klemens13/esp32s2-macropad/hardware/plate_mx_1to1.pdf

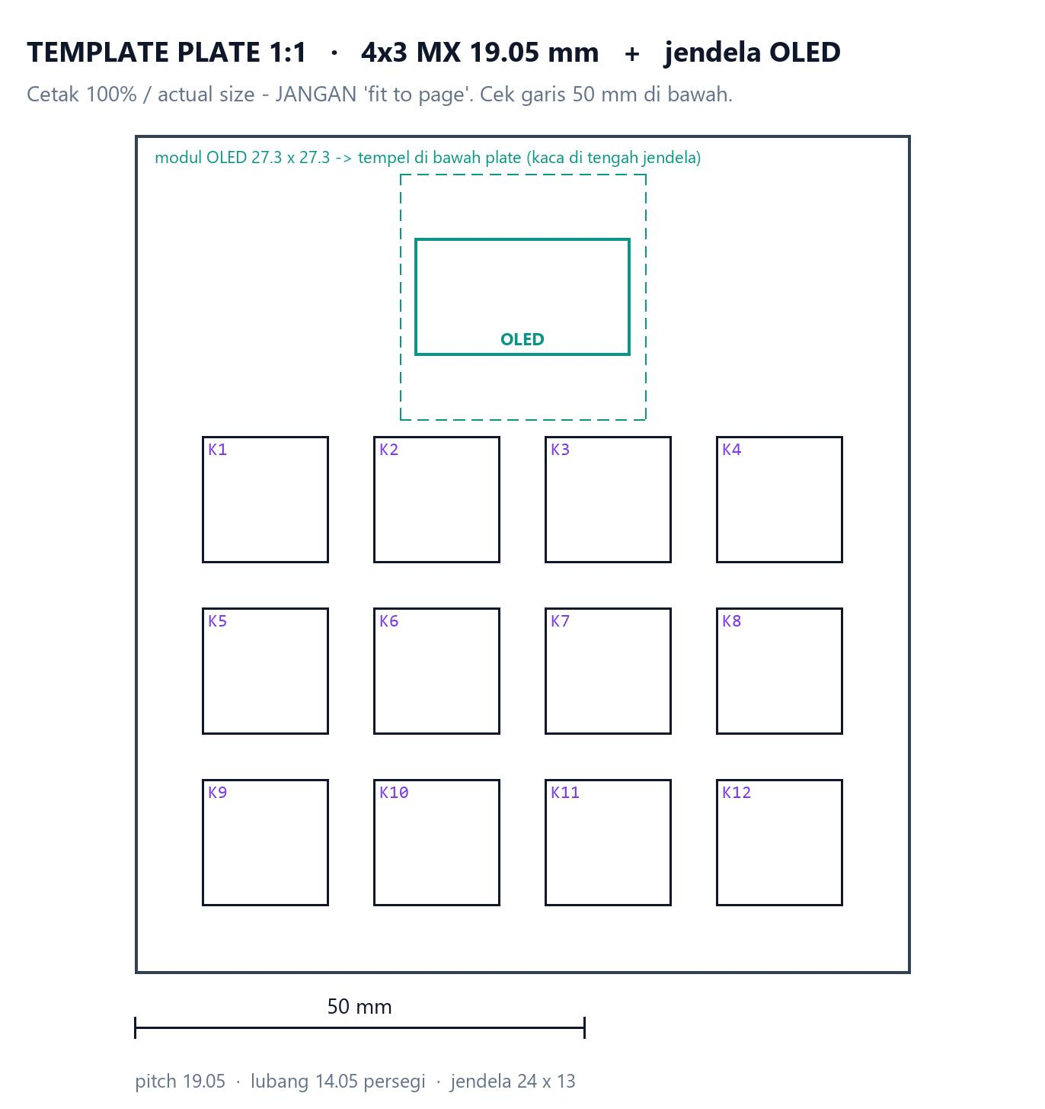
[picture p6: page 1]
