klemens13/esp32s2-macropad/hardware/plate_tactile_1to1.pdf

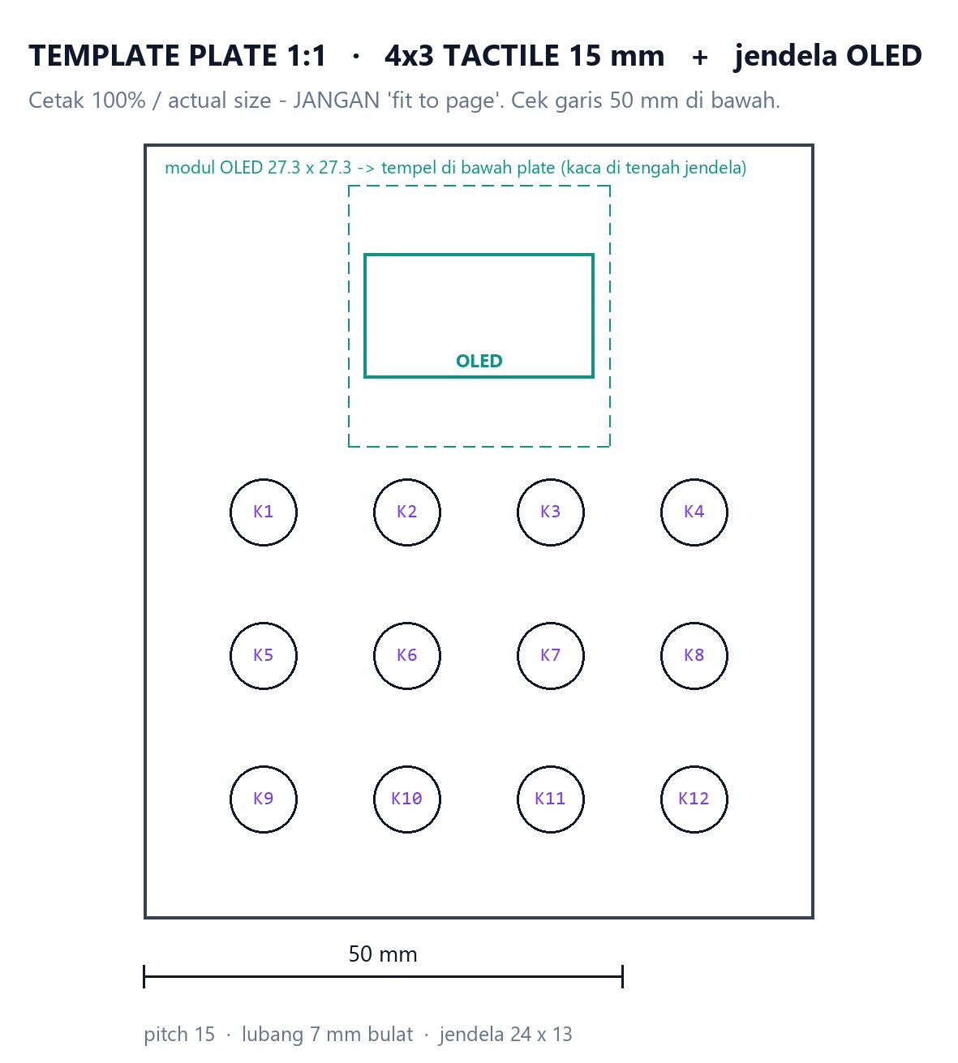
[picture p7: page 1]
