klemens13/esp32s2-macropad/firmware/font5x7.py

"""Font bitmap 5x7 (hanya karakter ini yang tersedia).

Dibuat otomatis oleh tools/gen_font.py - jangan diedit manual.
Setiap glyph = 5 byte, 1 byte per kolom, bit0 = baris paling atas.
"""

GLYPH_WIDTH = 5
GLYPH_HEIGHT = 7
ADVANCE = 6  # lebar glyph + 1 px jarak antar huruf

FONT = {
    0x20: b'\x00\x00\x00\x00\x00',  #  
    0x21: b'\x00\x00\x5f\x00\x00',  # !
    0x22: b'\x00\x03\x00\x03\x00',  # "
    0x25: b'\x63\x13\x08\x64\x63',  # %
    0x27: b'\x00\x00\x03\x00\x00',  # '
    0x28: b'\x00\x1c\x22\x41\x00',  # (
    0x29: b'\x00\x41\x22\x1c\x00',  # )
    0x2A: b'\x2a\x1c\x3e\x1c\x2a',  # *
    0x2B: b'\x08\x08\x3e\x08\x08',  # +
    0x2C: b'\x00\x40\x30\x30\x00',  # ,
    0x2D: b'\x08\x08\x08\x08\x08',  # -
    0x2E: b'\x00\x00\x60\x60\x00',  # .
    0x2F: b'\x60\x10\x08\x04\x03',  # /
    0x30: b'\x3e\x51\x49\x45\x3e',  # 0
    0x31: b'\x00\x42\x7f\x40\x00',  # 1
    0x32: b'\x42\x61\x51\x49\x46',  # 2
    0x33: b'\x21\x41\x45\x4b\x31',  # 3
    0x34: b'\x18\x14\x12\x7f\x10',  # 4
    0x35: b'\x27\x45\x45\x45\x39',  # 5
    0x36: b'\x3c\x4a\x49\x49\x30',  # 6
    0x37: b'\x01\x71\x09\x05\x03',  # 7
    0x38: b'\x36\x49\x49\x49\x36',  # 8
    0x39: b'\x06\x49\x49\x29\x1e',  # 9
    0x3A: b'\x00\x00\x36\x36\x00',  # :
    0x3C: b'\x08\x14\x22\x41\x00',  # <
    0x3D: b'\x14\x14\x14\x14\x14',  # =
    0x3E: b'\x00\x41\x22\x14\x08',  # >
    0x3F: b'\x02\x01\x51\x09\x06',  # ?
    0x41: b'\x7e\x09\x09\x09\x7e',  # A
    0x42: b'\x7f\x49\x49\x49\x36',  # B
    0x43: b'\x3e\x41\x41\x41\x22',  # C
    0x44: b'\x7f\x41\x41\x41\x3e',  # D
    0x45: b'\x7f\x49\x49\x49\x41',  # E
    0x46: b'\x7f\x09\x09\x09\x01',  # F
    0x47: b'\x3e\x41\x49\x49\x3a',  # G
    0x48: b'\x7f\x08\x08\x08\x7f',  # H
    0x49: b'\x00\x41\x7f\x41\x00',  # I
    0x4A: b'\x20\x40\x41\x3f\x01',  # J
    0x4B: b'\x7f\x08\x14\x22\x41',  # K
    0x4C: b'\x7f\x40\x40\x40\x40',  # L
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
}
