klemens13/esp32s2-macropad/(commit log)

2026-10-27 Macropad ESP32-S2 Mini: 12 tombol + OLED status/companion (versi MX & tactile)
    [bom.csv, case_mx.scad, case_tactile.scad]
2026-10-27 Tambah dukungan LOLIN S3 Mini dan ESP32-S3 Super Mini
    - peta pin dipindah ke firmware/profiles.py (satu sumber untuk firmware + gambar)
    - kb.py: pilih board lewat BOARD atau MACROPAD_BOARD di settings.toml
    - wiring: 3 gambar per board, tabel pin ketiga board di wiring.md
    - README: tabel board didukung, catatan BLE (S3) dan status alpha Super Mini
    [bom.csv]
2026-10-27 Render 3D case + perbaiki bug variabel di case_mx.scad
    - case_mx.scad: SCREEN_BAND vs screen_band (OpenSCAD case-sensitive) membuat
    plate_d/grid_y0/win_cy undefined -> geometri MX tidak pernah terbentuk benar
    - tools/render_case.py: renderer z-buffer (numpy) tanpa OpenGL
    - tools/render_case.ps1: ekspor STL via OpenSCAD lalu render jadi PNG
    - hardware/render_mx.png + render_tactile.png, dipakai di README
    [case_mx.scad]
